adafruit/Adafruit-Color-Newxie-TFT-Display-PCB/Adafruit Color Newxie TFT Display.brd

## EAGLE design Adafruit Color Newxie TFT Display.brd (2024-12-18)

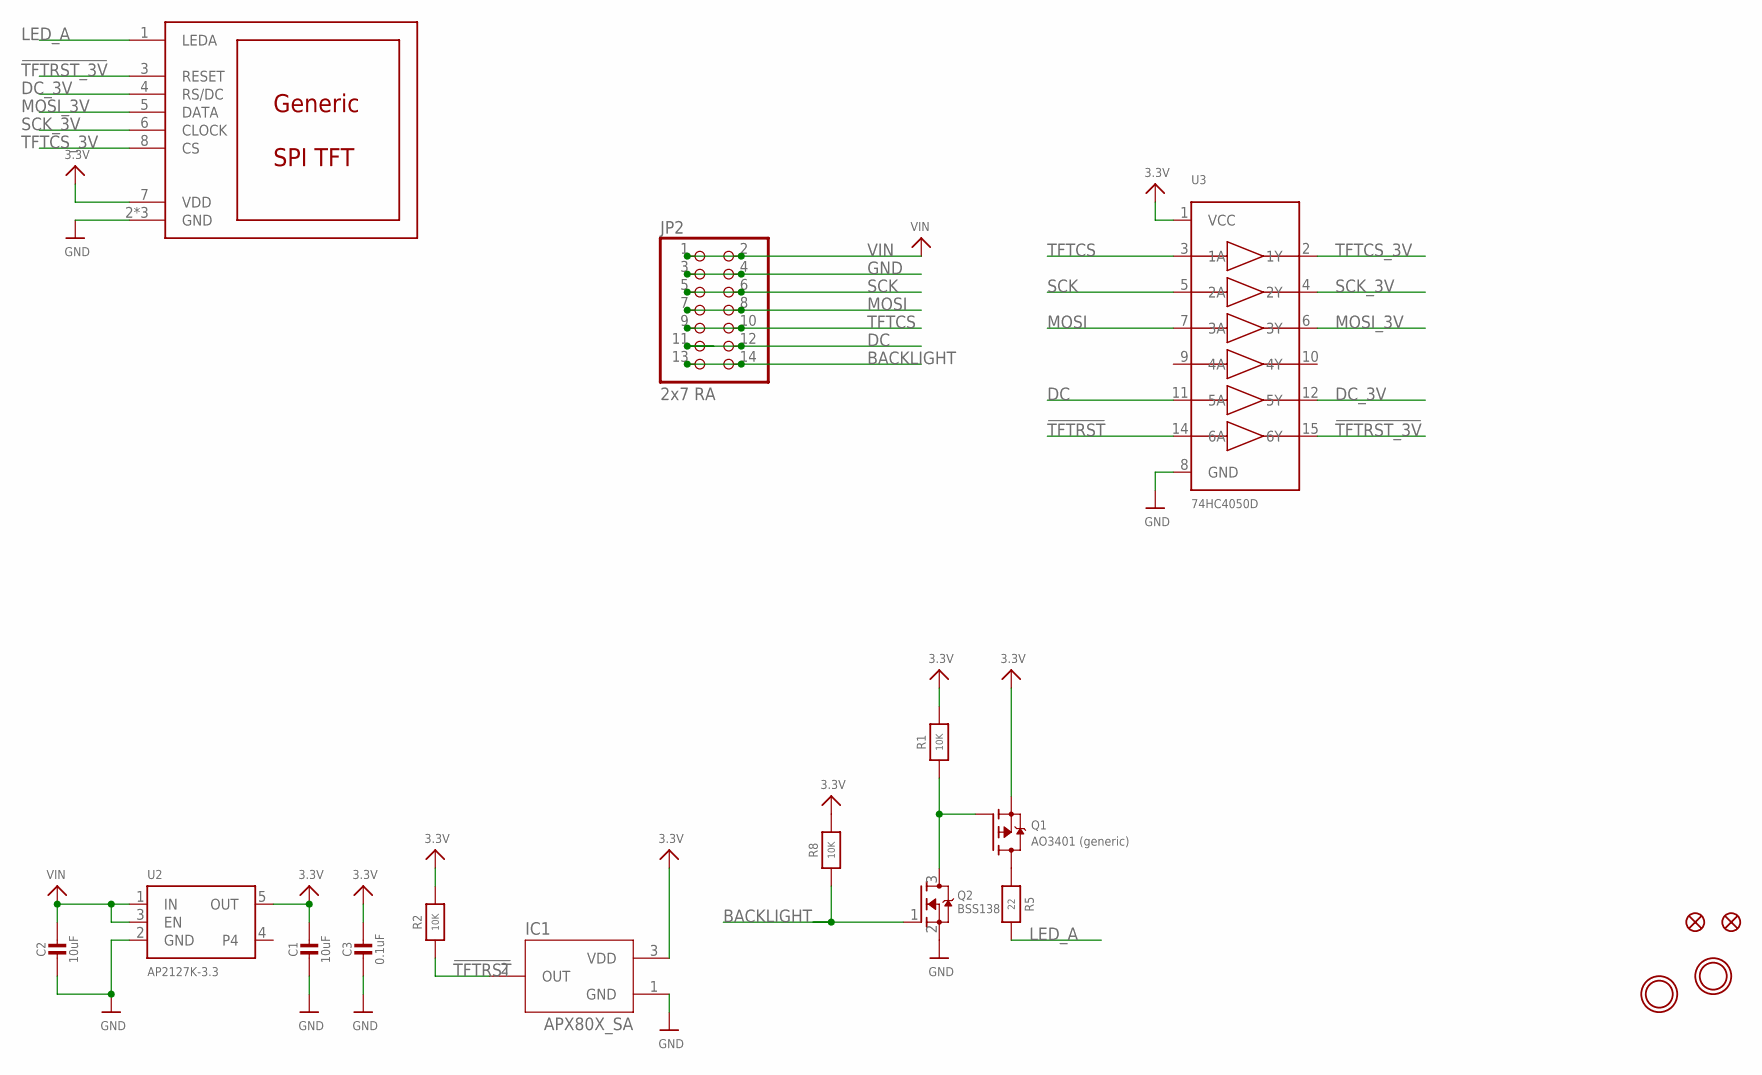
[picture p2: schematic Adafruit Color Newxie TFT Display.sch]

Parts:
C1, C2: 10uF; 0805-NO
C3: 0.1uF; 0603-NO
DISP2: DISP_LCD_GENERIC_SPI_NOLEDA_1.14_240X135_FPC; TFT_1.14IN_240X135_FPC
FID1, FID2: FIDUCIAL_1MM
IC1: APX80X_SA; SOT23-WIDE
JP2: 2x7 RA; 2X07_ROUND_70MIL
Q1: AO3401 (generic); SOT23-WIDE
Q2: BSS138; SOT23-WIDE
R1, R2, R8: 10K; 0603-NO
R5: 22; 0603-NO
U2: AP2127K-3.3; SOT23-5
U3: 74HC4050D; TSSOP16
U$9, U$10: MOUNTINGHOLE2.5; MOUNTINGHOLE_2.5_PLATED

Connections:
3.3V: C1.1, C3.1, DISP2.7 (VDD), IC1.3 (VDD), Q1.2 (S), R1.2, R2.2, R8.2, U2.5 (OUT), U3.1 (VCC)
!TFTRST: IC1.2 (OUT), R2.1, U3.14 (6A)
!TFTRST_3V: DISP2.3 (RESET), U3.15 (6Y)
BACKLIGHT: JP2.13, JP2.14, Q2.1 (G), R8.1
DC: JP2.11, JP2.12, U3.11 (5A)
DC_3V: DISP2.4 (RS/DC), U3.12 (5Y)
GND: C1.2, C2.2, C3.2, DISP2.2 (GND), DISP2.MT1 (GND), DISP2.MT2 (GND), IC1.1 (GND), JP2.3, JP2.4, Q2.2 (S), U2.2 (GND), U3.8 (GND)
LED_A: DISP2.1 (LEDA), R5.2
MOSI: JP2.7, JP2.8, U3.7 (3A)
MOSI_3V: DISP2.5 (DATA), U3.6 (3Y)
unnamed: Q1.3 (D), R5.1
unnamed: Q1.1 (G), Q2.3 (D), R1.1
SCK: JP2.5, JP2.6, U3.5 (2A)
SCK_3V: DISP2.6 (CLOCK), U3.4 (2Y)
TFTCS: JP2.9, JP2.10, U3.3 (1A)
TFTCS_3V: DISP2.8 (CS), U3.2 (1Y)
VIN: C2.1, JP2.1, JP2.2, U2.1 (IN), U2.3 (EN)

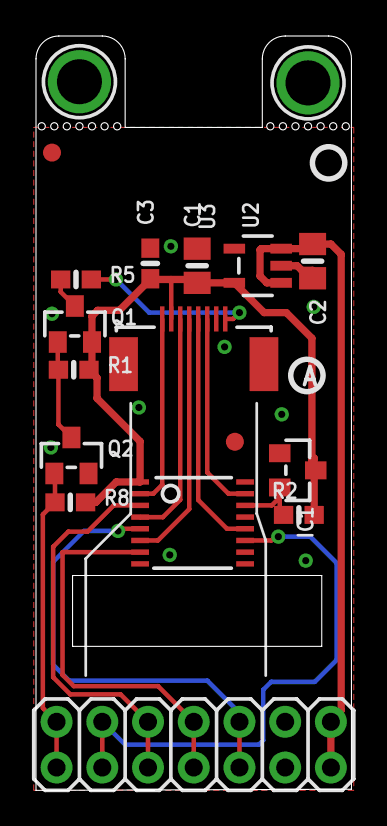
[picture p3: board Adafruit Color Newxie TFT Display.brd from above]

Board: 2 copper layers, 17.5 x 41.9 mm, 28 parts (1 on the bottom side), 17 nets.

Other parts of the board:
PLABEL0: PLABEL0
PLABEL1: PLABEL1
PLABEL2: PLABEL2
PLABEL3: PLABEL3
PLABEL4: PLABEL4
PLABEL5: PLABEL5
PLABEL6: PLABEL6
PLABEL7: PLABEL7
U$6, U$15: PCBFEAT-REV-040
